FOlszowski/OutdoorWeatherStation/README.md

# OutdoorWeatherStation
Project for Embedded Systems

Station general schematic:
outdoor_weather_station_diagram
