FOlszowski/OutdoorWeatherStation/Outdoor weather station prezentation.pdf

# Outdoor weather station

Filip Olszowski

Szymon Lis

# Objectives

- Powered by battery, charged by solar panel
- Measured values:
- Temperature
- Humidity
- Atmoshperic pressure
- Air Quality (particles PM1.0, PM2.5, PM10.0)
- Historical data collection
- Easy, accessible dashboard

# Microcontroller

As the brain of our system we chose ESP8266 (NodeMCU v3). It is a low cost microcontroller, but it meets all requirements such as:

- Wifi module
- Sleep function for saving power
- 3.3 V Logic
- I2C interface

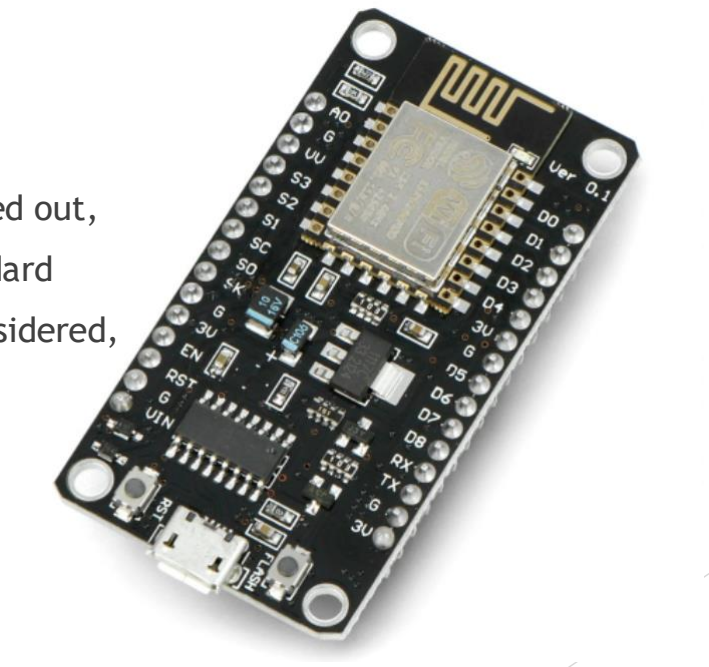
[picture p2: figure]

During project construction it turned out,

that it is not compatible with standard

arduino libraries which may be considered,

as significant disadvantage

Esp 8266 NodeMCU v3 controller

# Power supply

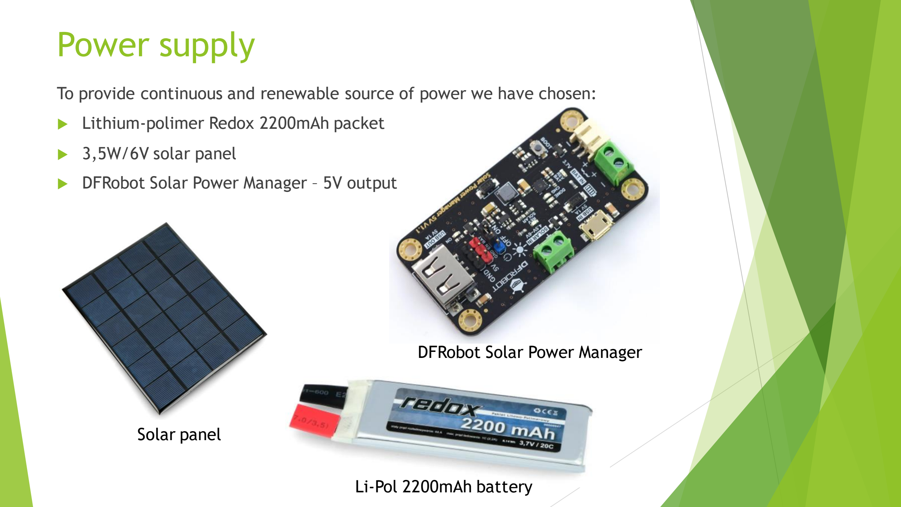
[picture p3: page 4]

To provide continuous and renewable source of power we have chosen:

- Lithium-polimer Redox 2200mAh packet
- 3,5W/6V solar panel
- DFRobot Solar Power Manager – 5V output

DFRobot Solar Power Manager

Solar panel

Li-Pol 2200mAh battery

# Sensors

The following sensors were used to measure all assumed quantites:

- SHT31-F - temperature (-40°C - 125°C ± 0.2°C) and humidity (0% - 100% ± 2%) sensor communicating via I2C
- BMP280 - Atmospheric Pressure (300hPa – 1100hPa ±0,12hPa) sensor communicating via I2C
- PMS3003 – particle (PM1.0, PM2.5, PM10.0) sensor communicating via UART

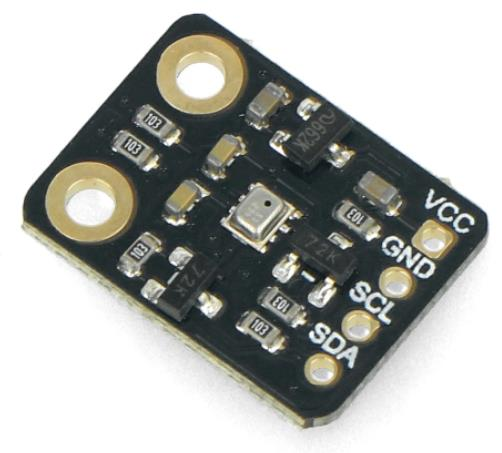
[picture p4: figure]

BMP280

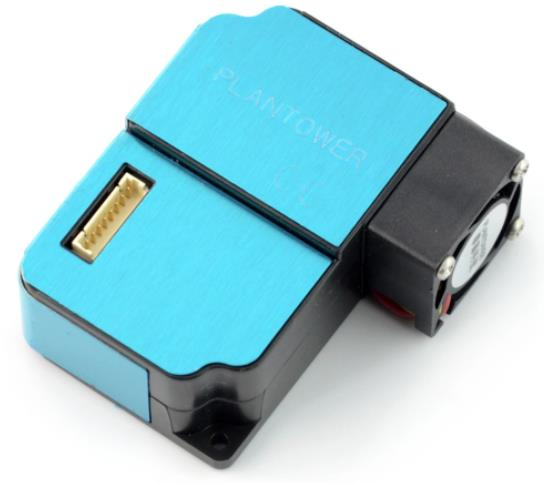
[picture p5: figure]

PMS3003

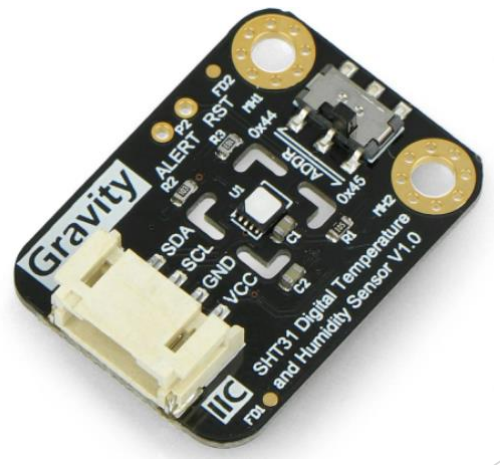
[picture p6: figure]

SHT31-F

# Construction

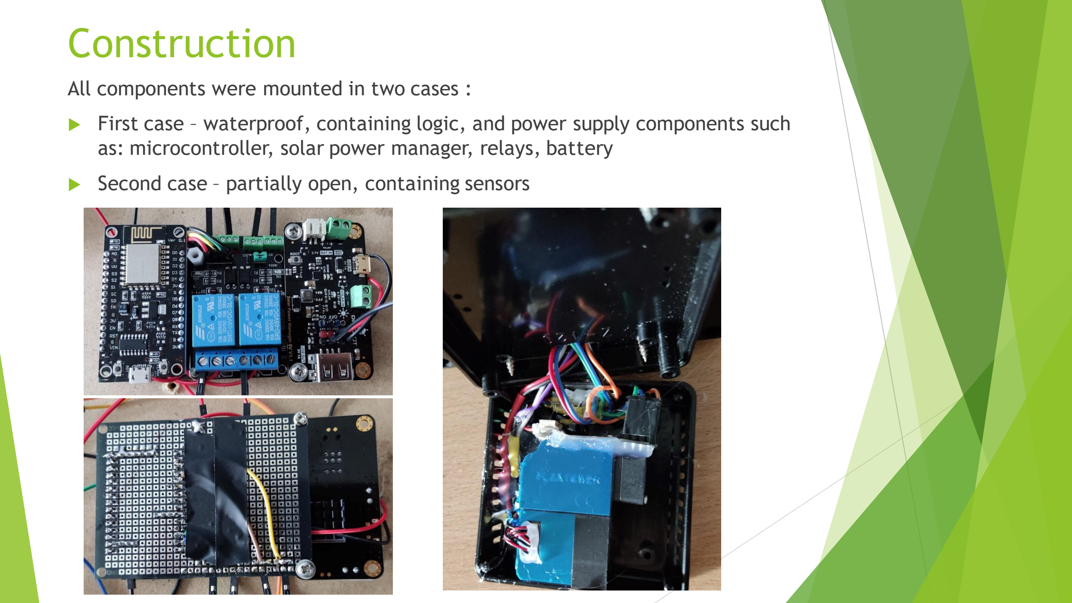
[picture p7: page 6]

All components were mounted in two cases :

- First case – waterproof, containing logic, and power supply components such as: microcontroller, solar power manager, relays, battery
- Second case – partially open, containing sensors

# Collecting data, dashboard

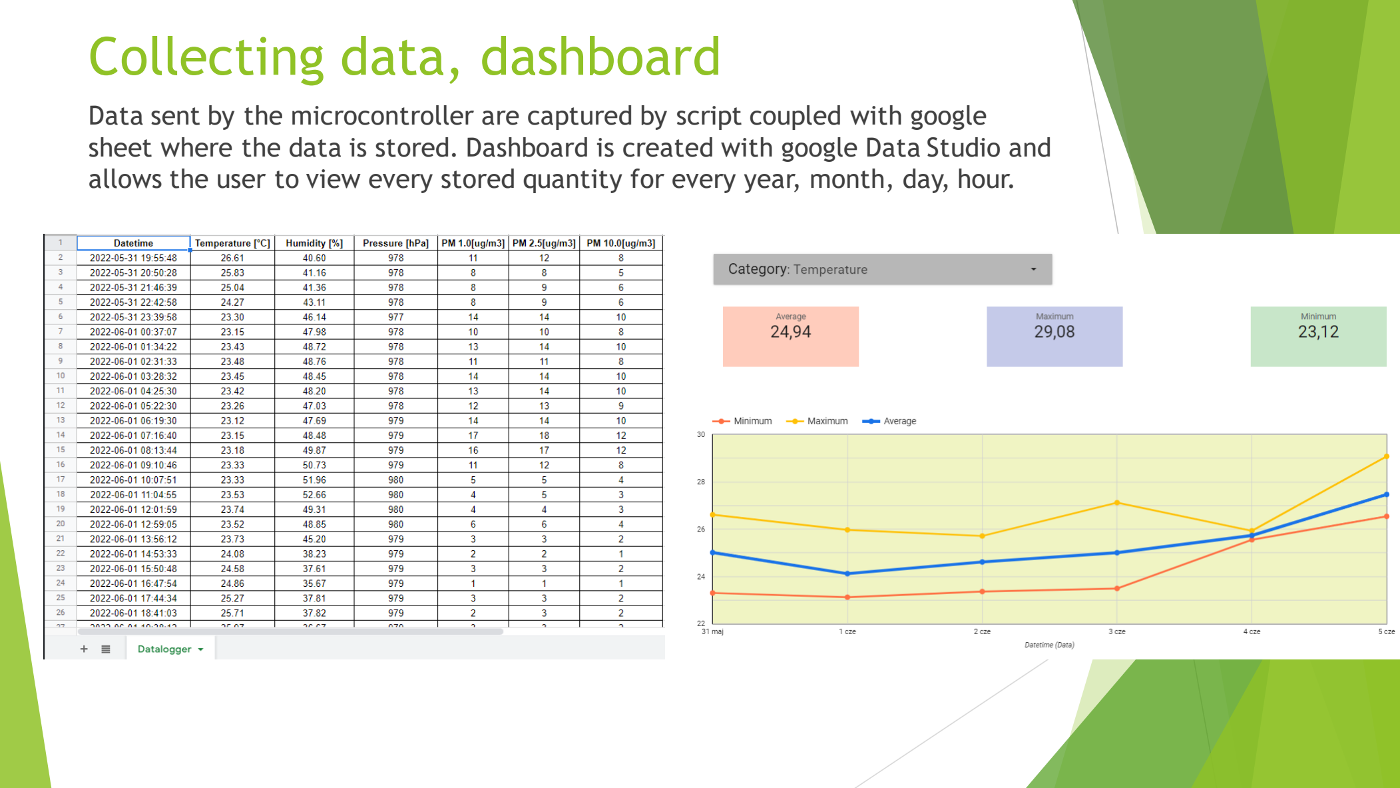
[picture p8: page 7]

Data sent by the microcontroller are captured by script coupled with google sheet where the data is stored. Dashboard is created with google Data Studio and allows the user to view every stored quantity for every year, month, day, hour.

# Summary

- Data is collected with 1 hour interval
- Battery provides power for approximately 4.5 days and can be recharded in

4-5 hours of strong sunlight

- Station measures temperature, humidity, atmoshperic pressure and particles in air
- After sealing the housing station can operate all year round (except particles measures – it can be stored in temperature up to -40°C but can work in temperaturę up to -10°C),
- Dashboard and data storage is done with free gogle tools so maintenance of the station is free
