FOlszowski/OutdoorWeatherStation/(commit log)

2022-05-22 Switches + PMS [Work in progress]
2022-05-23 added Parts List
    [Parts_list.xlsx]
2022-05-31 Fully working prototype
